harshabose/sagewire/README.md

# sagewire

Avionics wiring and system architecture documentation for **Sage**.

This repository holds the wiring definitions (connections, cable specifications, bill of materials) and the system architecture diagram for Sage's avionics.

## Status

Work in progress.

## Detailed wiring (WireViz)

One YAML file per system in `harness/`. Render one with:

```
wireviz -f hpst -o build harness\power_system.yaml
```

Needs Graphviz on the PATH. In pin lists, quote labels that YAML would read as booleans (`"NO"`, `"ON"`, `"Y"`).
