harshabose/sagewire/docs/CAN Termination for Servos.md

> [!NOTE] Statements
> 1. CubeOrange+ has 2 CAN ports and each one is terminated with a 120$\,\Omega$.
> 2. 4 Servos are DroneCAN protocol; with two on each wing split. Servos do have termination resistors built-in.
> 3. GPS and Airspeed sensor can share one CAN port and daisy-chained together with termination OFF on GPS.

what is to be done:
1. 
2. CAN terminator??
3. 5G modem to antenna
4. RF Antennas
5. A8MINI power
6. FC to Jetson telem
7. ESC capacitors

what cannot be done:
1. battery to PDB
2.
