harshabose/sagewire/docs/component_list.md

| Sr. No | Component Name | Tag  |
| --- | --- | ---- |
| 1 | Pixhawk CubeOrange | FCT  |
| 2 | Airspeed Sensor | SPD  |
| 3 | SF30/D LiDAR | LDR  |
| 4 | Sierra Precision Pro X2 | GPS  |
| 5 | StrobeIT Light | LED  |
| 6 | A2-MINI | A2M  |
| 7 | Doodle Labs Mesh Rider Mini RM-1400-42M3 | AIR  |
| 8 | Battery Front | BAT1 |
| 9 | Battery Back | BAT2 |
| 10 | KDE-UBEC | BEC  |
| 11 | AXLDrone PDB400 | PDB  |
| 12 | ESC | ESC  |
| 13 | Jetson Board (fix board) | JET  |
| 14 | TEVM-AR0234 Mono Camera\* | |
| 15 | Waveshare 5G Dongle | WAV  |
# Connections
