harshabose/sagewire/scrap/Avionics Selection.xlsx

Sheet: Sheet1
Component | Possible Product
Flight Controller | Cube Orange Plus | Weight
 |  | Cost
 | Remarks | Specific Specs
GNSS & RTK Base | Here 4 | 0.06 | Sierra PrecisionPoin Pro (https://www.sierraaerospace.in/) | 0.015 | Teravolt AeroNav-1 (https://www.teravolt.in/product-page/aeronav-1-dual-band-gnss) | 0.025
 |  | 42500 |  |  |  | 15000
 | u-blox F9P | L1 & L5 Bands | RTK | CAN Comm. | Ublox F9/F20 | L1+L2/ L1+L5/ L1+L2+L5 | RTK | CAN Comm. | (NavIC + L1/L5) | UART/I²C Comm.
Battery | mPower 12S 50Ah 400Wh/Kg | 6.336 | mPower 12S 25Ah 350 Wh/Kg | 5.88 | GenX 12S 29Ah 575 Wh/Kg (https://genxbattery.com/shop/genx-pro-solid-state-45-6v-12s-29000mah-3c-premium-lithium-ion-solid-state-rechargeable-battery-575wh-kg) | 5.36
 |  |  |  |  |  | 309265
 | 5C Peak Claimed | Splitting into 2 | 3C Conti. Claimed | 15C Peak Claimed | 2 Units in Parallel | 10C Conti. Claimed | 3C Peak Claimed | 2 Units in Parallel | 2C Conti. Claimed
Servos | HiTec MD950TW-DroneCAN (https://www.hiteccs.com/actuators/product-details/MD950TW-DroneCAN) | 4V - 8.4V | Zeus Z1500H-24V (https://zeus-actuators.com/15mm/Z1500H-24V) | 16V - 30V | Himark SF1607 (http://himarkuaveng.com/product-21898-182293.html) | 4.8V - 8.4V
 |  | 21500
 | 21 Kgcm - 35 Kgcm | 66.4 g | IP54 | CAN Comm. | 6.0 kg-cm - 20 kg-cm | 38 g | MIL-STD-810G | 90° | CAN Comm. | 6.5 kg-cm - 16 kg-cm | 49.5 g | IP64 | 120° | CAN Comm.
Airspeed Sensor | 3DR AUAV-L10D-M25125 (https://store.3dr.com/slim-auav-can-airspeed-sensor/) | 0.02 | Sierra TrueSpeed V2 (https://www.sierraaerospace.in/)
 |  | 14000
 | 4.5 V – 40 V | CAN Comm.
Altitude LiDAR
Current Sensor
3 Axis Camera | SIYI A8 Mini (https://robu.in/product/siyi-a8-mini-ultra-hd-6x-digital-zoom-gimbal-camera/) | 0.1
 |  | 26500
 | 4K Record | UART & SBUS | Ethernet | 1080p 3Axis Gimbal
Power Switch
BECs | Matek 12S Pro (https://robu.in/product/rts-mateksys-12s-pro-bec-9-55v-to-5v-8v-12v-5a/) | 0.005
 |  | 1650
 | Optional 5V, 8V & 12V | Peak 9A | 5 A Continuous
PDB | APD PDB500X (https://powerdrives.net/pdb500x) | 0.05 | Vector Technics Powercore MK2 (https://www.vectortechnics.com/power-electronics-products/powercore-mk2) | 0.16
 |  | 16000
 | 5V & 12V BECs onboard | 1000 A Burst | 500 A (Quad Setup) | Need to use 2 | 300 A (Peak)
Edge Computer | NVIDIA Jetson Orin Nano
GSM Module
LEDs & LED Controller | Teravolt StrobeIT (https://www.teravolt.in/product-page/strobeit) | 0.01
 |  | 1500
 | RGB LED (3W max) | Programmable | 5 V
RF Module | Doodle labs Nano | 0.135 | pMDDL2460 | 0.0483
 |  | 160000 |  | 200000
 | 4 Antennae | 330 Km Range | 4 Antennae | Not Defined
Dropping Mechanism
ESCs | Reflex Drive 12S 80A (https://reflexdrive.in/product/rd-a-series-esc-12s-80a/) | 0.113
 |  | 26000
 | 12S | IP57 | PWM & DSHOT | No Telemetry | 80A
Connectors
Motor Connectors | QS12 Connectors (https://robu.in/product/qs12-connector-black-anti-spark-connector/) | 320A Peak
 |  | 4 Pin Signal Connector
 | Gold Plated Brass | Anti Spark Connector

Sheet: Sheet2
Status | Component | Name | Country of Origin | Units | Weight (g) | Cost | CAD | Procurement Remark
Fixed | Flight Controller | Orange Cube+ Standard Set ADS-B | Taiwan | 1 | 73
 |  | 32-bit ARM Cortex-M4 (STM32F427 Rev 3) running at 168 MHz with 256 KB
Fixed | GNSS & RTK Base | Sierra PrecisionPoin Pro (https://www.sierraaerospace.in/) | India | 1 | 15
 |  | Ublox F9/F20 | L1+L2/ L1+L5/ L1+L2+L5 | RTK
Not Fixed | Battery | mPower 12S 25Ah, 10c, 350 Wh/Kg | India | 2 | 4200
Not Fixed | Servos | Zeus Z1500H-24V (https://zeus-actuators.com/15mm/Z1500H-24V) | Taiwan | 4* | 38
 |  | Continuous torque considered for cuise velocity and max deflection
Fixed | Airspeed Sensor | Sierra TrueSpeed V2 (https://www.sierraaerospace.in/) | India | 2 | ?
Fixed | Altitude LiDAR | LightWare GRF-500 (https://lightwarelidar.com/shop/grf-500/) | USA | 1 | 10.7
Fixed | Current Sensor | Integrated in AXL PDB | India | - | 0
Fixed | 3 Axis Camera | A8 Mini/ A2 Mini | China | 1 | 95/85
 |  | Need to search for alternatives
Not Fixed | Power Switch | High Head 22mm 3-50V |  | 1
 |  | Verify Weight and look for alternatives
Not Fixed | BECs | KDE-UBECUVC | USA |  | 90
Not Fixed | PDB | AXL 400 (https://shop.axldrone.com/products/400a-power-distribution-board/2411087000001838001) | India | 1 | 55
Fixed | Edge Computer | Jetson dev_kit with Orin NX 16 GB | USA | 1 | 175
Fixed | GSM Module | Dual -Telet with Waveshare Module | USA | 1
Fixed | LEDs & LED Controller | StrobeIT-Pro RGB Navigation Strobe | 3km+ Visibility (https://www.teravolt.in/product-page/strobeit-pro-dual-led-drone-strobe) | India | 6 | 8
 |  | Controler need to be verified with wire diagram
Fixed | RF Module | Doodle Labs RM-2450-12M3 mini Mesh Rider® (https://doodlelabs.com/products/radios/mini) | USA | 2 | 34
Not Fixed | Dropping Mechanism |  |  | 1
 |  | Actuator and required electronics to be selected
Fixed | ESCs | APD 120F3 (https://powerdrives.net/120f3) | Australia | 5 | 20
Not Fixed | Forward Motors |  |  | 1
Fixed | VTOL Motors | Vector Technics 8020 Pro (https://www.vectortechnics.com/motors-products/8020-pro-120-kv) | India | 4 | 580
Fixed | Forward Propeller | APC 18 × 10E (https://www.apcprop.com/product/18x10e/?v=13b5bfe96f3e) |  | 1 | 72.8
Not Fixed | VTOL Propeller |  |  | 4
 | Connectors
 | Motor Connectors
