harshabose/sagewire/scrap/initial_selection.xlsx

GSM Module |  | Flight Controller |  | Battery |  | Servos | Airspeed Sensor |  | Altitude LiDAR |  | 3 Axis Camera | BEC |  | PDB |  | RF System | ESC
Min Requirements |  | Min Requirements |  | Min Requirements |  |  | Min Requirements |  | Min Requirements |  | Min Requirements | Min Requirements |  | Min Requirements
1. Low number of Antennas 2. Low Cost 3. Non-Chinese 4. -30C to 70C operational temperature 5. Support Airtel (5G-NSA, 4G LTE) and Jio (5G-SA, 4G LTE) Airtel 4G LTE -B1, B5, B40, B3, B8; 5G NSA - n8, n3, n1, n78, n258 Jio 4G LTE -B40, B3, B5 ; Jio 5G NSA - n28, n78, n258 |  |  |  | 1. 12S, 50Ah, high energy density 2. 400A draw |  | # todo |  |  | 1. DroneCAN/UART comm 2. 200m range (500m prefred) 3. Opererable in high lux 4. IP rated? 5. Non-chinese |  | 1. 3 axis stabilised gimbal 2. Compatible with MAVLINK/Drone 3. Cost similar to SIYI A8-MINI ($250) 4. Weight similar to SIYI A8-MINI (95g) 5. upto 10x (digital; low-priority) 6. Non-chinese | 1. 5V 3A Cont. 5A Burst 2. 5V 5A Cont. 10A Burst 3. 2X 12V 10A Cont. 15A Burst 4. Non-chinese |  | 1. 400A continuous current, 12S 2. Each ESC leg should have atleast 100A 3. Support for atleast 4 ESC legs in setup 4. BEC - 5V (x2) 3A/5A, 12V(x2) 10A/10A cont. (optional) 5. Current, Voltage measurement 6. Non-chinese |  |  | 1. 80A Cont. 100A Burst 12S 3. under 150g 3. non-chinese
Selection #1 |  | Selection #1 |  | Selection #1 |  |  | Selection #1 |  | Selection #1 (Sensor Team) |  | Selection #1 | Selection #1 |  | Selection #1 |  | Selection #1 | Selection #1
Name | Sierra EM8695 RedCap | Name | Cube Orange Plus | Name | mPower 12S |  | Name | 3DR AUAV-L10D-M25125 | Name | LightWare SF30/D LiDAR |  | Name | Hub-E High-Performance H4 Cube | Name | AxlDrone PDB400A | RC7 | Name | Reflex Drive A-Series ESC 80A
Antennas | 2 | Weight | 73g | Config | 1 |  | Pressure Range | +/- 10 inH20 | Range/Accuracy | 0.2m - 200m / +/- 5cm (<500reads/s) |  | Weight | 102g | Weight | 55g | doodle lab | Weight | 90g (without cable)
Country of Origin | USA | Country of Origin | Australian (manuf. Taiwan) | Energy Density | 400 Wh/kg |  | Weight | 2.8g | Weight | 35g |  | Input Voltage | 4-14S | Cont. Current | 400A |  | IP Rating | IP57
Cost | $168 | Cost | 64000 INR | Capacity | 50Ah |  | Country of Origin | USA | Voltage | 4.5V to 5.5V |  | 5V Outputs | 5.3V X2 (10A Cont.; 15A Burst) | Peak Current | 500A |  | Interface | PWM, DShot300
Buy Links | Techship (https://techship.com/product/sierra-wireless-em8695-5g-redcap-m2/?variant=002) | Processor | Main: STM32H757ZI ARM Cortex M7 (400 MHz) Fallover: STM32F103 ARM Cortex M3 (24MHz) | Weight | 6.336 kg |  | Interface | DroneCan | Interface | Serial (FC) |  | 12V Outputs | 12V X2 (10A Cont.; 15A Burst) | ESC legs | 8 |  | Telemetry | YES
Op. Temp. Range | -30C to +70C | Sensors | Accelerometer (x3); Gyroscope (x3); Compass (x1); Barometer (x2) | Cost |  |  | Op. Temp. Range | -40 °C to 85 °C | Op. Temp | -20 to 60°C |  | Selection #2 (search for alternatives) |  | ESC cont. Current | - |  | Current | 80A (Cont.) & 100A (Burst)
Interface | M2 | Op. Temp. Range | -10C to 55C | Cont. C Rating | 3C |  | Selection #2 |  | Test Plan |  |  | Test Plan |  | ESC max. Current | 200A |  | Test Plan
Uplink/Downlink (Mbps) | 100/220 | Test Plan |  | Max. C Rating | 5C |  | Name | AUAV DroneCAN Airspeed & Baro Sensor CN | Delegated to Sensor Suite Team |  |  | Load Regulation Test (requires DC power supply and DC load) | Test: Validate DC voltage stability across the 14S input range (36V to 51V) and from 0A to 10A continuous draw per rail. Procedure: 1. Wire the input to a DC supply adjustable from 36V to 51V. 2. Connect electronic loads to each 5V and 12V output channel. 3. Stepping througgh delta 1V on DC supply, step current load from 0A to 10A in 1A increments per rail and record terminal voltage with a calibrated digital multimeter. 4. Monitor internal buck ICs, inductors, and PCB copper traces using thermal camera. after reaching thermal equilibrium (delta T < 1C/min) Output voltages should remain within ±6% of nominal under all line/load combinations (4.80V–5.5V for 5.3V rails; 11.3V–12.7V for 12V rails). Surface temperature of power components remains < 110C, no thermal shutdown triggers | BECs 5V 3A/5A | YES/NO |  | Continuous & Burst Load Thermal Test | Test: Verify continuous 80A current-handling capability and 100A burst threshold (15-second duration) without MOSFET thermal runaway or component degradation. Procedure: 1. Supply maximum rated battery voltage (up to 12S / 50.4V) and apply a constant 80A current load for 10 minutes. (run BH NIPPLE at max throttle sea level ~80A) 2. Apply 100A (how to control current consp.? could reduce voltage?) burst current steps for 15 seconds at 2-minute intervals during the continuous run. 3. Track surface temperatures and solder pads, wires using thermal camera. Maximum surface temperature remains below 100C(?)
5G bands | n1, n2, n3, n5, n7, n8, n12, n13, n14, n18, n20, n25, n26, n28, n30, n38, n40, n41, n48, n66, n70, n71, n77, n78, n79 | NONE (NOT sure if FC team's code/hardware or Ardupilot) |  | Selection #2 |  |  | Pressure Range | +/- 10 inH20 |  |  |  |  |  | BECs 12V 10A/10A | NO/NO
4g bands | B1, B2, B3, B4, B5, B7, B8, B12, B13, B14, B17, B18, B19, B20, B25, B26, B28, B30, B34, B38, B39, B40, B41, B42, B43, B48, B66, B71, B106 |  |  | Name | mPower 12S |  | Weight | 10g |  |  |  |  |  | Current Voltage sensors | YES
Selection #2 |  |  |  | Config | 1+1 (parallel) |  | Country of Origin | German |  |  |  |  |  | Require Anti-spark? | NO
Name | Telit Cinterion FN920C04-WW 5G RedCap M.2 |  |  | Energy Density | 350 Wh/kg |  | Interface | Redundant DroneCAN x2 |  |  |  |  |  | Test Plan
Antennas | 2 |  |  | Capacity | 25Ah + 25 Ah |  | Op. Temp. Range | -40 °C to 85 °C |  |  |  |  |  | Current/Voltage Sensor Accuracy & Calib | Test: Validate current measurement precision and calibrate scale/offset parameters across the full operating range (0A to Imax). Procedure: 1. Wire the current sensor in series with a precision programmable DC electronic load (buy this) and a bench multimeter. 2. Measure zero-current offset at boot (I = 0A) to verify baseline reading (BATT_AMP_OFFSET) (follow ardupilot guide on their website) 3. Perform a 10-step ascending and descending current sweep from 0A to maximum rated current 4. Log telemetry output I_ouput versus reference output I_load to calculate BATT_AMP_OFFSET, hysteresis, and linearity (R^2 > 0.999). Target full-scale accuracy is 1.5%. 5. Similarily with voltage with varying DC supply (range = 36V to 52V for 12S) BATT_VOLT_MULT (follow ardupilot guide on their website)
Country of Origin | Italy |  |  | Weight | 5.88 kg |  | Selection #3
Cost | $160 |  |  | Cost |  |  | Name | Beyond Robotrix Air Data Module Mini
Buy Links | Techship (https://techship.com/product/telit-cinterion-fn920c04-ww-5g-redcap-m2/?variant=006) |  |  | Cont. C Rating | 10C |  | Pressure Range | +/- 10 inH20
Op. Temp. Range | -40C to +85C |  |  | Max. C Rating | 15C |  | Weight | 3.9g
Interface | M2 |  |  | Test Plan |  |  | Country of Origin | UK
Uplink/Downlink (Mbps) | 123/223 |  |  |  |  |  | Interface | CAN
5G bands | n1, n2, n3, n5, n7, n8, n12, n13, n14, n18, n20, n25, n26, n28, n30, n38, n40, n41, n48, n53, n66, n70, n71, n77, n78, n79 |  |  | Parallel Current Sharing |  |  | Op. Temp. Range | -40 °C to +85 °C
4g bands | B1, B2, B3, B4, B5, B7, B8, B12, B13, B14, B17, B18, B19, B20, B25, B26, B28, B30, B34, B38, B39, B40, B41, B42, B43, B48, B66, B71 |  |  | Inrush Cross-Charging when Voltage Mismatch Test |  |  | Test Plan |  |  |  |  |  |  |  |  |  | IP Protection Test (Required?)
Selection #3 |  |  |  | 400A Continuous Full-Discharge Thermal Test (8C Rate) |  |  | Accuracy Test Plan | Test: The sensor should be able to measure accurately, specifically - stall speed, cruise speed, AoA, side-slip, and high-speed (dive speed) Procedure (from Arduploit website): 1. Fly at constant altitude (100-200m) in circles with ARPSPD_USE=0 (but collect data), varying speeds 2. Calculate average TAS and compare with GPS speed vectors - error should be <3% 3. Repeat this with varying speed (and AoA) |  |  |  | Burst Load Capacity Test (requires DC power suppl, DC load and oscilloscope) | Test: Evaluate voltage recovery and transient sag during maximum 15A burst events on individual and combined channels. Procedure: 1. Set input supply to nominal 12S voltage (50.4V). 2. Program the DC load to step from 2A (low) continuous baseline to 15A peak with a 1-second pulse duration (slew rate ≥ 2.5A/µs). 3. Measure transient voltage dip, overshoot, and settling time using an oscilloscope (check if we have this in lab) connected directly across the BEC output pads. Repeat test with pulsed load applied simultaneously across all 4 output channels (dual 5V + dual 12V). Peak-to-peak transient deviation remains < 6% of nominal voltage, recovery time < 200µs (?), and no triggering of over-current protection.
Name | CQM220 5G RedCap IoT Module |  |  | Single-Pack Failure Test | Test: Confirm battery safety if one pack unexpectedly fails during full-power (max motor current; 300A) operation. Procedure: 1. Operate system at 300A total load (150A per pack) connected to PDB. Trigger an intentional disconnect/fuse-switch off on Pack 1. 2. Measure instantaneous voltage spike, current ramp on Pack 2 (from 150A to 300A) on telemetry. Remaining pack absorbs the current without triggering over-current shutdown (since 300A is within its single-pack 10C / 250A continuous and 15C burst rating)
Antennas | 2
Country of Origin | USA (RnD India)
Cost | Enquiry |  |  |  |  |  |  |  |  |  |  |  |  | High-Load Thermal; BEC Voltage regulation @ High-Load; EMF Leak | Test: Validate thermal equilibrium under continuous 400A total load 100A per leg across 4 legs) at 12S nominal voltage (48V - 50.4V. Procedure: 1. Mount the PDB inside on a test rig. Wire 4 ESC output legs to DC electronic loads 100A per channel) and connect input terminals to a 12S DC power supply. 2. Apply continuous 400A load for 15 minutes or until thermal steady-state is established (Delta T < 1C/min). 3. Record surface temperature at the current shunts, main power solder pads, and heavy copper traces every 30 seconds using thermal imaging. Temp should be stable and < 100C(?) 4. Measure total system voltage drop (V_in - V_leg) - should be less than 1-2% (?); and 5V BEC voltage regulation - should be less than 6% (5.3V) ripple. 5. While max current draw, measure the raw EMF samples - power, frequency, bandwidth. Verify if any rogue EMF falls in GNSS/5G/2.4GHz/5.8GHz range.
Op. Temp. Range | -30C to 85C |  |  |  |  |  | Calibration Test Plan | Test: The sensor's error with position, altitude, operations etc should be considered. Ardupilot provides default features to correct this Procedure (from Arduploit website): 1. Set ARSPD_USE = 0 to not use the airspeed sensor during test 2. Set the current ambient temp. in BARO_GND_TEMP (Ardupilot uses internal temp automatically) 3. ARSPD_RATIO = 2.0 (Default) ARSPD_AUTOCAL = 1. And FLWA for 5 minutes in Loiter and Fly in circles at low speed in calm wind (<3m/s) 4. The ARSPED_RATIO value will automatically change (1.5 to 3.0). Change ARSPD_AUTOCAL=0 to conclude the test. If the ratio is outside the limit, there is a leak. NOTE: Do the same at high altitude (every 2000m will give 10% error). Ardupilot auto corrects this. |  |  |  | Short-Circuit & Protection Recovery Test | Test: Confirm output short-circuit protection and auto-recovery prevent board damage during shorts. Procedure: 1. Apply a direct very small resistance short circuit < 10mOhms sequentially to each 5V and 12V output terminal under nominal 12S input voltage. 2. Hold short circuit for 30 seconds and record fault behavior (hiccup mode vs. latch-off). 3. Remove short circuit and measure time-to-recovery for voltage output (multimeter) Zero physical damage to PCB or ICs, shorted current limited safely, and full auto-recovery within few second after fault removal.
Interface | M2 available |  |  |  |  |  | Presure Leak Test | Test: The hardware (pipes, tubes, connectors, etc) should be leak proof Procedure: 1. Attach a precision pressure calibrator (or syringe with a digital manometer) to the pitot port while leaving the static port exposed to ambient air. 2. Apply positive pressure equivalent to maximum operational dynamic pressure (VD). 3. Verify pressure decay is less than $0.5hPa/min (<2% total pressure loss). 4. Repeat the procedure on the static port using negative suction pressure.
Uplink/Downlink (Mbps) | 120/220
5G bands | WW - n1, n2, n3, n5, n7, n8, n12, n13, n14, n18, n20, n25, n26, n28, n38, n40, n41, n48, n66, n71, n77, n78 IN - n1, n3, n5, n8, n38, n40, n41, n48, n77, n78 EAJ - n1, n3, n5, n7, n8, n18, n20, n26, n28, n38, n40, n41, n48, n77, n78
4g bands | WW - B1, B2, B3, B4, B5, B7, B8, B12, B13, B14, B17, B18, B19, B20, B25, B26, B28, B34, B38, B39, B40, B41, B42, B43, B48, B66, B71 IN - B1, B3, B5, B8, B38, B40, B41, B42, B43, B48 EAJ - B1, B3, B5, B7, B8, B18, B19, B20, B26, B28, B34, B38, B39, B40, B41, B42, B43, B48
Comment | RedCap are ideal for drone - lower cost, lower power, lower antennas but, only work 5G-SA (no NSA) and 4G networks. Airtel is 5G-NSA (soon transitioning to SA). Jio is 5G-SA. This means when using airtel, modules will fallback to 4G LTE+. This is fine as in most deployment places we are already using 4G.
Test Plan
Delegated to comms. team
