harshabose/sagewire/scrap/SAGE_Master.step

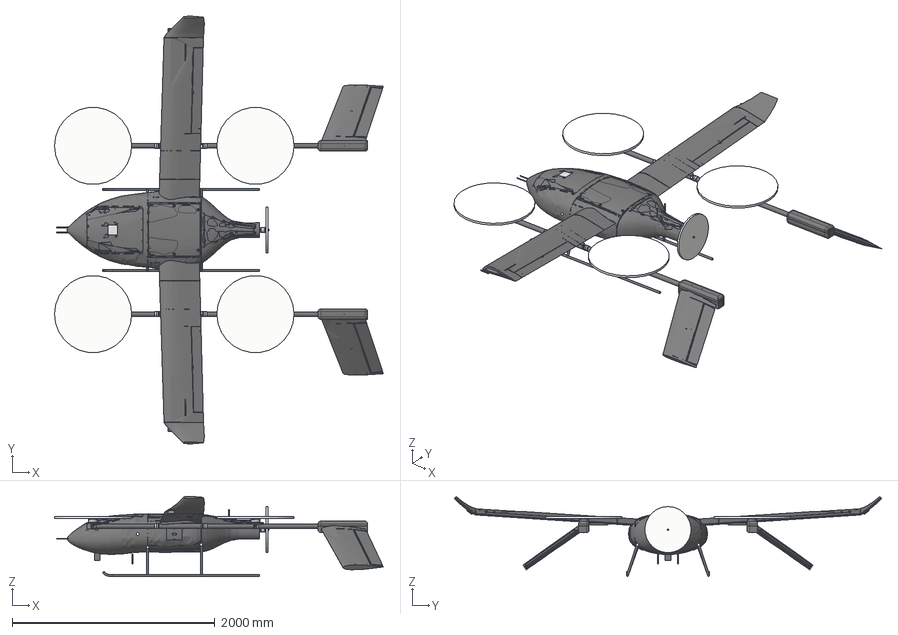
[picture p1: CAD file, 2026-11-13]
scrap/SAGE_Master.step
3246.6 x 4221.3 x 790.4 mm
RF_Window_GNSS_GFRP
HW_M3x10_CSK_Captive_Screw x 24
HW_Nutplate_M3_2Lug_Floating x 24
GNSS_Holder_PA12
HW_Kit_SparFitting_Inner_Main x 2
HW_Kit_SparFitting_Inner_Aux x 2
HW_Kit_SparFitting_Outer_Main x 2
HW_Kit_SparFitting_Outer_Aux x 2
COTS_Servo_Z1500H x 6
COTS_Servo_Arm_Single_13 x 4
HW_Pushrod_M2_L52 x 4
15.1_Payload_Top_Hatch
15.2_Bay_Door_L
15.3_Bay_Door_R
CON_XT90_Female x 4
CON_M8_4pin_Female x 4
CON_DSUB25_Female x 2
CON_M8_3pin_Female x 4
CON_Phase3_Bullet4mm_Female x 4
AV_ESC_APD_120F3 x 5
CON_DSUB25_Male x 2
CON_XT90_Male x 4
CON_M8_4pin_Male x 4
HW_Hinge_Pin_20mm x 16
CON_M8_3pin_Male x 4
CON_Phase3_Bullet4mm_Male x 4
42.1_Tail_Boom_Joint_R
41.1_Tail_Boom_Joint_L
COTS_Motor_VT8020PRO_120KV x 4
FAB_VTOL_Motor_Mount_v5 x 4
AV_Prop_APC_18x10E
COTS_Motor_VT4130FW_300KV
HW_Washer_M8_DIN125
HW_Nut_M8_Nyloc_DIN985
BATT_Bay_Receptacle_R
01_Pack_12S1P_LiPo
02_Case_PA12_Latches_Slides
03_Blade_Plug
BATT_Bay_Receptacle_L
01_Pack_12S1P_LiPo_1
02_Case_PA12_Latches_Slides_1
03_Blade_Plug_1
AV_FC_CubeOrangePlus_ADSB
AV_Radio_DoodleLabs_RM2450_Mini x 2
AV_GSM_DualTelet_Waveshare
AV_GNSS_Sierra_PrecisionPoint_Pro
AV_LiDAR_LightWare_GRF500
AV_Airspeed_Sierra_TrueSpeedV2 x 2
AV_Power_Switch_22mm
AV_Jetson_OrinNX_DevKit
AV_PDB_AXL400
AV_BEC_KDE_UBECUVC
AV_Camera_SIYI_A8mini
AV_LED_StrobeIT_Pro x 2
AV_Antenna_Whip x 4
AV_LED_StrobeIT x 4
70_Landing_Gear
