harshabose/sagewire/harness/actuators_system.yaml

# Actuators system harness (work in progress)
# Scope: wing split -> ESC power input -> motor phase leads for the four VTOL motors (numbered as in
# the ArduPilot Quad X default: 1 front right, 2 rear left, 3 front left, 4 rear right)
# (XT90 male on the wing side, APD 120F3 ESC, Vector Technics 8020 PRO 120KV motor), plus the
# forward-thrust ESC and motor.
# The fuselage side (PDB ESC pads -> XT90 female) lives in power_system.yaml. The ESC signal (T, S)
# wiring is in the wing split section. The two input capacitors that come in each ESC box (not
# installed) are soldered with their own legs straight onto the ESC capacitor pads (CAP_xxx_A and
# CAP_xxx_B, cables W_ACT_32 to W_ACT_41); their spec is not in the APD docs.
# The forward-thrust ESC (same APD 120F3) is wired to the PDB in power_system.yaml (ESC_FWD_IN);
# its signal, capacitor and motor phase pads are here (ESC_FWD_SIG, ESC_FWD_CAP, ESC_FWD_PH), and
# the motor is a Vector Technics VT4130 300KV with an 18 inch propeller.
# The wing split signal connectors (DB-25, one pair per wing), the wing servos, the wing LEDs and the
# CAN splitter ports are at the end of the connectors section. They are wired with NO SHARING: every
# servo, LED and ESC signal link has its own power, ground and signal pins through the DB-25, and
# every servo has its own CAN pair plus a GND wire to its own port on the passive CAN splitter
# (ports 2 to 5; port 1, the Cube link, is in flight_control_system.yaml). The servo end of each wing
# cable is an M5 male plug that mates with the servo's own M5 lead. The DB-25 pin order
# below is provisional (not fixed yet). The fuselage side sources (12 V, 5 V, Cube outputs) are not
# modelled yet, so those fuselage pins only show the mate to the wing side, apart from the CAN
# and GND wires to the splitter.
#
# Cable lengths are 0 for now (placeholder). Real lengths come after the layout analysis.
# Gauges and colors are recommendations, see the comment above each cable.

metadata:
  title: Actuators system
  description: VTOL motor power, wing split (DB-25, no sharing), servos, LEDs, ESC signals, CAN splitter ports

connectors:

  # Wing split, wing side: one XT90 male per VTOL motor ESC. It mates with the XT90 female
  # in power_system.yaml (XT90_VTOL{n}_F). Synthetic pin IDs; the housing is keyed, so polarity
  # cannot be reversed.
  # Variant fixed for now: plain XT90 (no anti-spark). TODO: revisit the variant (XT90-S anti-spark
  # or XT90H) and set the part number. It must match the female side. XT90 is rated for 90 A continuous: check against the real ESC peak current.
  XT90_VTOL1_M:
    type: XT90 male
    subtype: male
    manufacturer: Amass
    notes: "VTOL motor 1 (front right) power, wing split (wing side)"
    pinlabels: [POS, NEG]

  XT90_VTOL2_M:
    type: XT90 male
    subtype: male
    manufacturer: Amass
    notes: "VTOL motor 2 (rear left) power, wing split (wing side)"
    pinlabels: [POS, NEG]

  XT90_VTOL3_M:
    type: XT90 male
    subtype: male
    manufacturer: Amass
    notes: "VTOL motor 3 (front left) power, wing split (wing side)"
    pinlabels: [POS, NEG]

  XT90_VTOL4_M:
    type: XT90 male
    subtype: male
    manufacturer: Amass
    notes: "VTOL motor 4 (rear right) power, wing split (wing side)"
    pinlabels: [POS, NEG]

  # ESC: APD 120F3 (120 A rating), one per VTOL motor. All its connections are solder pads, so
  # there is nothing to buy on the ESC side; the harness wires are soldered straight to the pads.
  # The board has three groups of pads, modelled as three connectors per ESC. Pin IDs are
  # synthetic (pads have no numbers), in label order.
  # TODO: the pad picture was of the F3[X] board; confirm the 120F3 pad layout is the same.
  # Capacitors: each 120F3 box has 2 input capacitors (not installed), modelled further down as
  # CAP_xxx_A and CAP_xxx_B. APD says that if the ESC is more than 12 cm from the power source an
  # additional capacitor is needed on top of the included ones (2 or 3 extra for high current;
  # Panasonic FM/FS or Rubycon ZLJ). The wing ESCs will be over 12 cm (wing split).
  # TODO: the value and voltage of the included capacitors are not in the APD docs. Read the
  # markings on them, then decide the extra capacitors for the long input leads.
  #
  # Battery input pads (+ and -, the two large pads).
  ESC_VTOL1_IN:
    type: Solder pads
    notes: "VTOL motor 1 (front right) ESC battery input, + and -"
    pinlabels: [IN_POS, IN_NEG]
    ignore_in_bom: true

  ESC_VTOL2_IN:
    type: Solder pads
    notes: "VTOL motor 2 (rear left) ESC battery input, + and -"
    pinlabels: [IN_POS, IN_NEG]
    ignore_in_bom: true

  ESC_VTOL3_IN:
    type: Solder pads
    notes: "VTOL motor 3 (front left) ESC battery input, + and -"
    pinlabels: [IN_POS, IN_NEG]
    ignore_in_bom: true

  ESC_VTOL4_IN:
    type: Solder pads
    notes: "VTOL motor 4 (rear right) ESC battery input, + and -"
    pinlabels: [IN_POS, IN_NEG]
    ignore_in_bom: true

  # Motor phase pads on the ESC (three pads). Sensorless motor, so the three phases can go to any
  # pad: swapping any two phase wires reverses the spin direction (APD also has a motor reverse
  # solder tab). Pad labels are synthetic.
  # TODO: check the real pad labels on the 120F3 board and set the spin direction per motor.
  ESC_VTOL1_PH:
    type: Solder pads
    notes: "VTOL motor 1 (front right) ESC motor phase pads"
    pinlabels: [PH_A, PH_B, PH_C]
    ignore_in_bom: true

  ESC_VTOL2_PH:
    type: Solder pads
    notes: "VTOL motor 2 (rear left) ESC motor phase pads"
    pinlabels: [PH_A, PH_B, PH_C]
    ignore_in_bom: true

  ESC_VTOL3_PH:
    type: Solder pads
    notes: "VTOL motor 3 (front left) ESC motor phase pads"
    pinlabels: [PH_A, PH_B, PH_C]
    ignore_in_bom: true

  ESC_VTOL4_PH:
    type: Solder pads
    notes: "VTOL motor 4 (rear right) ESC motor phase pads"
    pinlabels: [PH_A, PH_B, PH_C]
    ignore_in_bom: true

  # Vector Technics 8020 PRO 120KV motor, one per VTOL arm. The three phase leads exit the motor
  # body and are modelled as cable W_ACT_05 to W_ACT_08, so nothing goes in the BOM for them.
  # TODO: lead length, gauge and any connector on the leads are not in the seller listing; check
  # the Vector Technics datasheet or the motor itself.
  MOT_VTOL1:
    type: Motor (three-phase leads exit the body)
    manufacturer: Vector Technics
    notes: "VTOL motor 1 (front right, CCW): 8020 PRO 120KV, 12S, 50 A (180 s) maximum continuous per the seller listing"
    pinlabels: [PH_A, PH_B, PH_C]
    ignore_in_bom: true

  MOT_VTOL2:
    type: Motor (three-phase leads exit the body)
    manufacturer: Vector Technics
    notes: "VTOL motor 2 (rear left, CCW): 8020 PRO 120KV, 12S, 50 A (180 s) maximum continuous per the seller listing"
    pinlabels: [PH_A, PH_B, PH_C]
    ignore_in_bom: true

  MOT_VTOL3:
    type: Motor (three-phase leads exit the body)
    manufacturer: Vector Technics
    notes: "VTOL motor 3 (front left, CW): 8020 PRO 120KV, 12S, 50 A (180 s) maximum continuous per the seller listing"
    pinlabels: [PH_A, PH_B, PH_C]
    ignore_in_bom: true

  MOT_VTOL4:
    type: Motor (three-phase leads exit the body)
    manufacturer: Vector Technics
    notes: "VTOL motor 4 (rear right, CW): 8020 PRO 120KV, 12S, 50 A (180 s) maximum continuous per the seller listing"
    pinlabels: [PH_A, PH_B, PH_C]
    ignore_in_bom: true

  # Signal pads (three small pads, top to bottom: T, S, -).
  # T = ESC telemetry output, S = signal input (PWM), - = signal ground.
  ESC_VTOL1_SIG:
    type: Solder pads
    notes: "VTOL motor 1 (front right) ESC signal pads: T telemetry out, S signal in, GND signal ground"
    pinlabels: [T, S, SIG_GND]
    ignore_in_bom: true

  ESC_VTOL2_SIG:
    type: Solder pads
    notes: "VTOL motor 2 (rear left) ESC signal pads: T telemetry out, S signal in, GND signal ground"
    pinlabels: [T, S, SIG_GND]
    ignore_in_bom: true

  ESC_VTOL3_SIG:
    type: Solder pads
    notes: "VTOL motor 3 (front left) ESC signal pads: T telemetry out, S signal in, GND signal ground"
    pinlabels: [T, S, SIG_GND]
    ignore_in_bom: true

  ESC_VTOL4_SIG:
    type: Solder pads
    notes: "VTOL motor 4 (rear right) ESC signal pads: T telemetry out, S signal in, GND signal ground"
    pinlabels: [T, S, SIG_GND]
    ignore_in_bom: true

  # Capacitor pads (+ and -, marked "Capacitor Mounting Position" on the board, at the top edge).
  # The two capacitors from the ESC box are soldered straight onto these pads with their own legs
  # (CAP_VTOL1_A and CAP_VTOL1_B, both on the same pad pair, in parallel). Extra capacitors for
  # the long input leads are not added yet.
  ESC_VTOL1_CAP:
    type: Solder pads
    notes: "VTOL motor 1 (front right) ESC capacitor pads, + and -. Observe polarity."
    pinlabels: [CAP_POS, CAP_NEG]
    ignore_in_bom: true

  ESC_VTOL2_CAP:
    type: Solder pads
    notes: "VTOL motor 2 (rear left) ESC capacitor pads, + and -. Observe polarity."
    pinlabels: [CAP_POS, CAP_NEG]
    ignore_in_bom: true

  ESC_VTOL3_CAP:
    type: Solder pads
    notes: "VTOL motor 3 (front left) ESC capacitor pads, + and -. Observe polarity."
    pinlabels: [CAP_POS, CAP_NEG]
    ignore_in_bom: true

  ESC_VTOL4_CAP:
    type: Solder pads
    notes: "VTOL motor 4 (rear right) ESC capacitor pads, + and -. Observe polarity."
    pinlabels: [CAP_POS, CAP_NEG]
    ignore_in_bom: true

  # --- Forward-thrust ESC (APD 120F3, same as the VTOL ESCs) ---------------------------
  # Battery input pads are in power_system.yaml (ESC_FWD_IN). Same pad layout as above.
  # Signal pads (top to bottom: T, S, -). T = telemetry out, S = signal in (PWM), - = signal ground.
  ESC_FWD_SIG:
    type: Solder pads
    notes: "Forward ESC signal pads: T telemetry out, S signal in, GND signal ground"
    pinlabels: [T, S, SIG_GND]
    ignore_in_bom: true

  # Capacitor pads (+ and -). The two capacitors from the ESC box are soldered straight onto them
  # with their own legs (CAP_FWD_A and CAP_FWD_B); same capacitor notes as the VTOL ESCs apply.
  ESC_FWD_CAP:
    type: Solder pads
    notes: "Forward ESC capacitor pads, + and -. Observe polarity."
    pinlabels: [CAP_POS, CAP_NEG]
    ignore_in_bom: true

  # Motor phase pads on the forward ESC. Same notes as the VTOL ESCs: any pad order works, and
  # swapping two phase wires reverses the spin direction. Pad labels are synthetic.
  ESC_FWD_PH:
    type: Solder pads
    notes: "Forward ESC motor phase pads"
    pinlabels: [PH_A, PH_B, PH_C]
    ignore_in_bom: true

  # Forward-thrust motor: Vector Technics VT4130 300KV, 18 inch propeller. The three phase leads
  # exit the motor body and are modelled as cable W_ACT_09.
  # TODO: lead length, gauge and any connector are not known; check the Vector Technics datasheet or
  # the motor. The test data is for a smaller propeller; the 18 inch propeller draws more current
  # (agreed with the vendor), expected to be similar to the VTOL motors.
  MOT_FWD:
    type: Motor (three-phase leads exit the body)
    manufacturer: Vector Technics
    notes: "Forward motor: VT4130 300KV, 18 inch propeller"
    pinlabels: [PH_A, PH_B, PH_C]
    ignore_in_bom: true

  # ---- ESC input capacitors from the box (2 per ESC) -----------------------------------
  # Each APD 120F3 ships with 2 input capacitors, not installed. They belong to the ESC, so nothing
  # goes in the BOM. The spec (value, voltage) is not in the APD docs; read it off the capacitor.
  # Polarity: the positive leg is the longer one, the negative side has the grey stripe on the body.
  # Legs as short as possible (APD).
  CAP_VTOL1_A:
    type: Electrolytic capacitor (spec not known)
    notes: "VTOL motor 1 (front right) ESC input capacitor 1 of 2, from the ESC box"
    pinlabels: [CAP_POS, CAP_NEG]
    ignore_in_bom: true

  CAP_VTOL1_B:
    type: Electrolytic capacitor (spec not known)
    notes: "VTOL motor 1 (front right) ESC input capacitor 2 of 2, from the ESC box"
    pinlabels: [CAP_POS, CAP_NEG]
    ignore_in_bom: true

  CAP_VTOL2_A:
    type: Electrolytic capacitor (spec not known)
    notes: "VTOL motor 2 (rear left) ESC input capacitor 1 of 2, from the ESC box"
    pinlabels: [CAP_POS, CAP_NEG]
    ignore_in_bom: true

  CAP_VTOL2_B:
    type: Electrolytic capacitor (spec not known)
    notes: "VTOL motor 2 (rear left) ESC input capacitor 2 of 2, from the ESC box"
    pinlabels: [CAP_POS, CAP_NEG]
    ignore_in_bom: true

  CAP_VTOL3_A:
    type: Electrolytic capacitor (spec not known)
    notes: "VTOL motor 3 (front left) ESC input capacitor 1 of 2, from the ESC box"
    pinlabels: [CAP_POS, CAP_NEG]
    ignore_in_bom: true

  CAP_VTOL3_B:
    type: Electrolytic capacitor (spec not known)
    notes: "VTOL motor 3 (front left) ESC input capacitor 2 of 2, from the ESC box"
    pinlabels: [CAP_POS, CAP_NEG]
    ignore_in_bom: true

  CAP_VTOL4_A:
    type: Electrolytic capacitor (spec not known)
    notes: "VTOL motor 4 (rear right) ESC input capacitor 1 of 2, from the ESC box"
    pinlabels: [CAP_POS, CAP_NEG]
    ignore_in_bom: true

  CAP_VTOL4_B:
    type: Electrolytic capacitor (spec not known)
    notes: "VTOL motor 4 (rear right) ESC input capacitor 2 of 2, from the ESC box"
    pinlabels: [CAP_POS, CAP_NEG]
    ignore_in_bom: true

  CAP_FWD_A:
    type: Electrolytic capacitor (spec not known)
    notes: "Forward ESC input capacitor 1 of 2, from the ESC box"
    pinlabels: [CAP_POS, CAP_NEG]
    ignore_in_bom: true

  CAP_FWD_B:
    type: Electrolytic capacitor (spec not known)
    notes: "Forward ESC input capacitor 2 of 2, from the ESC box"
    pinlabels: [CAP_POS, CAP_NEG]
    ignore_in_bom: true

  # ==== Wing split (DB-25) and wing consumers ============================================
  # Each wing carries 2 servos (DroneCAN), 3 LEDs (PWM) and 2 ESC signal links (T, S, GND).
  # Wired with NO SHARING (user decision for now): per servo 12 V and GND, per LED 5 V, signal and
  # GND, per ESC T, S and its own signal GND, and a separate CAN pair per servo. That is 23 pins per
  # wing; pins 24 and 25 are spare. The pin current rating is above what the loads need, including
  # the servos (user check).
  #
  # TODO: the DB-25 pin map below is PROVISIONAL on purpose. Freeze it in a later pass.
  # Provisional DB-25 pin map (identical on both wings, so the harnesses mirror):
  #   1-4   servo 1: V+, GND, CAN_H, CAN_L        5-8   servo 2: V+, GND, CAN_H, CAN_L
  #   9-11  ESC 1 (forward boom): T, S, GND       12-14 ESC 2 (aft boom): T, S, GND
  #   15-17 LED 1: 5 V, signal, GND               18-20 LED 2: 5 V, signal, GND
  #   21-23 wingtip LED: 5 V, signal, GND         24-25 spare
  # The CAN pair of each servo sits on adjacent pins (twist the pair in the cable).
  # Motor numbers follow the ArduPilot QuadPlane Quad X default: 1 front right, 2 rear left,
  # 3 front left, 4 rear right. So the left wing carries VTOL motor 3 (ESC 1, forward boom) and
  # VTOL motor 2 (ESC 2, aft boom); the right wing carries VTOL motor 1 (ESC 1) and 4 (ESC 2).
  # Servos and LEDs: servo 1 and 2, LEDs L1, L2 (StrobeIT-Pro) and LT (wingtip) per wing.
  #
  # DB-25 pair per wing: socket (female) on the fuselage side, plug (male) on the wing side, so the
  # live pins are not exposed on the fuselage side. This gender choice is an assumption.
  # TODO: shell material and part numbers, contact type (crimp or solder), the contact wire range (it
  # must take both the 22 AWG power wires and the 26 AWG signal wires) and the mating hood.
  # TODO: the pin order is not fixed, so all pin references below use the pin labels. Change the
  # label list in the four connectors together.
  SPLIT_L_FUS:
    type: D-sub DB-25 socket
    subtype: female
    pincount: 25
    pinlabels: [SRV1_VPOS, SRV1_GND, SRV1_CANH, SRV1_CANL, SRV2_VPOS, SRV2_GND, SRV2_CANH, SRV2_CANL, ESC1_T, ESC1_S, ESC1_SGND, ESC2_T, ESC2_S, ESC2_SGND, LED1_5V, LED1_SIG, LED1_GND, LED2_5V, LED2_SIG, LED2_GND, LEDT_5V, LEDT_SIG, LEDT_GND, SPARE24, SPARE25]
    hide_disconnected_pins: true
    notes: "Left wing split, fuselage side. Provisional pin map, see above."

  SPLIT_L_WING:
    type: D-sub DB-25 plug
    subtype: male
    pincount: 25
    pinlabels: [SRV1_VPOS, SRV1_GND, SRV1_CANH, SRV1_CANL, SRV2_VPOS, SRV2_GND, SRV2_CANH, SRV2_CANL, ESC1_T, ESC1_S, ESC1_SGND, ESC2_T, ESC2_S, ESC2_SGND, LED1_5V, LED1_SIG, LED1_GND, LED2_5V, LED2_SIG, LED2_GND, LEDT_5V, LEDT_SIG, LEDT_GND, SPARE24, SPARE25]
    hide_disconnected_pins: true
    notes: "Left wing split, wing side. Provisional pin map, see above."

  SPLIT_R_FUS:
    type: D-sub DB-25 socket
    subtype: female
    pincount: 25
    pinlabels: [SRV1_VPOS, SRV1_GND, SRV1_CANH, SRV1_CANL, SRV2_VPOS, SRV2_GND, SRV2_CANH, SRV2_CANL, ESC1_T, ESC1_S, ESC1_SGND, ESC2_T, ESC2_S, ESC2_SGND, LED1_5V, LED1_SIG, LED1_GND, LED2_5V, LED2_SIG, LED2_GND, LEDT_5V, LEDT_SIG, LEDT_GND, SPARE24, SPARE25]
    hide_disconnected_pins: true
    notes: "Right wing split, fuselage side. Provisional pin map, see above."

  SPLIT_R_WING:
    type: D-sub DB-25 plug
    subtype: male
    pincount: 25
    pinlabels: [SRV1_VPOS, SRV1_GND, SRV1_CANH, SRV1_CANL, SRV2_VPOS, SRV2_GND, SRV2_CANH, SRV2_CANL, ESC1_T, ESC1_S, ESC1_SGND, ESC2_T, ESC2_S, ESC2_SGND, LED1_5V, LED1_SIG, LED1_GND, LED2_5V, LED2_SIG, LED2_GND, LEDT_5V, LEDT_SIG, LEDT_GND, SPARE24, SPARE25]
    hide_disconnected_pins: true
    notes: "Right wing split, wing side. Provisional pin map, see above."

  # Zeus Z1500-12V servo, DroneCAN version, one connector per servo. The servo has a 200 mm lead
  # (0.14 mm2 / AWG 26, UL1061) ending in an M5 waterproof 4-pin female connector (datasheet page
  # 10, "M5 Wire"). DroneCAN pin definition: 1 power +, 2 power GND, 3 CAN High, 4 CAN Low.
  # Seen from the mating face the contacts are 3 top left, 4 top right, 2 bottom left, 1 bottom
  # right, with the key at the bottom. Rated 12 V (7 to 15 V); rated current 0.7 A, stall 1.3 A,
  # peak 2.2 A each. The lead belongs to the servo, so nothing goes in the BOM. The mating M5 male
  # plug on the wing cable is SRV_xx_M below.
  SRV_L1:
    type: M5 waterproof 4-pin female (servo lead)
    subtype: female
    manufacturer: Zeus
    notes: "Z1500-12V DroneCAN servo, left wing servo 1. 12 V, 0.7 A rated, 2.2 A peak."
    pinlabels: [V_POS, GND, CAN_H, CAN_L]
    ignore_in_bom: true

  SRV_L2:
    type: M5 waterproof 4-pin female (servo lead)
    subtype: female
    manufacturer: Zeus
    notes: "Z1500-12V DroneCAN servo, left wing servo 2. 12 V, 0.7 A rated, 2.2 A peak."
    pinlabels: [V_POS, GND, CAN_H, CAN_L]
    ignore_in_bom: true

  SRV_R1:
    type: M5 waterproof 4-pin female (servo lead)
    subtype: female
    manufacturer: Zeus
    notes: "Z1500-12V DroneCAN servo, right wing servo 1. 12 V, 0.7 A rated, 2.2 A peak."
    pinlabels: [V_POS, GND, CAN_H, CAN_L]
    ignore_in_bom: true

  SRV_R2:
    type: M5 waterproof 4-pin female (servo lead)
    subtype: female
    manufacturer: Zeus
    notes: "Z1500-12V DroneCAN servo, right wing servo 2. 12 V, 0.7 A rated, 2.2 A peak."
    pinlabels: [V_POS, GND, CAN_H, CAN_L]
    ignore_in_bom: true

  # M5 waterproof 4-pin male plug on the wing cable, one per servo. It mates with the servo's own
  # M5 female lead (SRV_xx above), pin for pin: 1 power +, 2 power GND, 3 CAN High, 4 CAN Low
  # (same numbering as the servo lead, datasheet page 10). The plug is bought, so it is in the BOM.
  # All four wires into the plug are 26 AWG (W_ACT_10 to W_ACT_13 and W_ACT_19 to W_ACT_22), chosen
  # to fit a small M5 solder cup (usually about 24 AWG or thinner).
  # TODO: part number, contact type (solder cup is usual) and the wire range it accepts. Also check
  # the plug's pin current rating against the 2.2 A servo peak.
  SRV_L1_M:
    type: M5 waterproof 4-pin male plug (cable end)
    subtype: male
    notes: "M5 male plug on the left wing servo 1 cable. Mates with the servo lead SRV_L1."
    pinlabels: [V_POS, GND, CAN_H, CAN_L]

  SRV_L2_M:
    type: M5 waterproof 4-pin male plug (cable end)
    subtype: male
    notes: "M5 male plug on the left wing servo 2 cable. Mates with the servo lead SRV_L2."
    pinlabels: [V_POS, GND, CAN_H, CAN_L]

  SRV_R1_M:
    type: M5 waterproof 4-pin male plug (cable end)
    subtype: male
    notes: "M5 male plug on the right wing servo 1 cable. Mates with the servo lead SRV_R1."
    pinlabels: [V_POS, GND, CAN_H, CAN_L]

  SRV_R2_M:
    type: M5 waterproof 4-pin male plug (cable end)
    subtype: male
    notes: "M5 male plug on the right wing servo 2 cable. Mates with the servo lead SRV_R2."
    pinlabels: [V_POS, GND, CAN_H, CAN_L]

  # Teravolt StrobeIT-Pro (two per wing) and StrobeIT (wingtip, one per wing). Both have a
  # standard 3-pin servo-style interface on three solder pads: 5 V input (1 A max), PWM signal,
  # ground. Use a supply that can give 800 mA peak per LED (full-bright strobe).
  # WARNING: the pad order of the two models is mirrored, so a straight cable from the same
  # harness plug would reverse the supply. Pin IDs below are the pad positions left to right as
  # drawn in the vendor pictures: StrobeIT-Pro is +, S, -; StrobeIT is -, S, +.
  # TODO: lead or header type to solder on (not decided).
  LED_L1:
    type: Solder pads
    manufacturer: Teravolt
    notes: "StrobeIT-Pro, left wing LED 1. Pads left to right: 5V, SIGNAL (PWM), GND."
    pinlabels: [5V, SIGNAL, GND]
    ignore_in_bom: true

  LED_L2:
    type: Solder pads
    manufacturer: Teravolt
    notes: "StrobeIT-Pro, left wing LED 2. Pads left to right: 5V, SIGNAL (PWM), GND."
    pinlabels: [5V, SIGNAL, GND]
    ignore_in_bom: true

  LED_LT:
    type: Solder pads
    manufacturer: Teravolt
    notes: "StrobeIT, left wingtip LED. Pads left to right: GND, SIGNAL (PWM), 5V."
    pinlabels: [GND, SIGNAL, 5V]
    ignore_in_bom: true

  LED_R1:
    type: Solder pads
    manufacturer: Teravolt
    notes: "StrobeIT-Pro, right wing LED 1. Pads left to right: 5V, SIGNAL (PWM), GND."
    pinlabels: [5V, SIGNAL, GND]
    ignore_in_bom: true

  LED_R2:
    type: Solder pads
    manufacturer: Teravolt
    notes: "StrobeIT-Pro, right wing LED 2. Pads left to right: 5V, SIGNAL (PWM), GND."
    pinlabels: [5V, SIGNAL, GND]
    ignore_in_bom: true

  LED_RT:
    type: Solder pads
    manufacturer: Teravolt
    notes: "StrobeIT, right wingtip LED. Pads left to right: GND, SIGNAL (PWM), 5V."
    pinlabels: [GND, SIGNAL, 5V]
    ignore_in_bom: true

  # CAN splitter: SwiftWing 6-port passive splitter, JST-GH 4-pin ports. All ports are bussed in
  # parallel inside the splitter (pin 1 = +5 V, 2 = CAN_H, 3 = CAN_L, 4 = GND on every port); it has
  # no termination and no isolation. Each port is modelled as its own connector (harness side
  # housing). Port 1 goes to the Cube CAN2 port and is modelled in flight_control_system.yaml
  # (CAN_SPL_P1), so it is not defined here; ports 2 to 5 take one servo each (no sharing); port 6
  # is spare. Which physical port is which does not matter, they are all the same net.
  # WARNING: the splitter pin 1 is 5 V and bussed. The servos have 12 V on their pin 1, so the servo
  # branches use only CAN_H, CAN_L and GND: pin 1 stays empty on ports 2 to 5. The GND wire is the
  # same DB-25 pin as the servo power GND, so once the 12 V supply is wired the servo return current
  # has two paths (the power wire and, through the splitter GND, the Cube); keep that in mind.
  # NOTE: the Zeus servos have NO built-in CAN termination (mostly confirmed, not yet measured), so
  # the bus end at the Cube (120 ohm on the Cube port) is the only termination on this branch.
  # TODO: confirm by measuring CAN_H to CAN_L on a servo, power off. If a servo does turn out to
  # have a built-in 120 ohm, four of them in parallel (30 ohm) on the bussed splitter would be far
  # below the 60 ohm of a correctly terminated bus. (docs/CAN Termination for Servos.md still
  # says the servos are terminated; that doc is being rewritten.) With no sharing the bus is a star, so the stubs (wing half-span plus fuselage
  # run) are far over the 0.3 m rule of thumb; lower the bitrate if the servos allow it.
  # TODO: GH housing part number and contact type (GHR-04V-S with SSHL-002T-P0.2 for 26 AWG), and
  # confirm that the splitter ports are SM04B-GHS-TB headers.
  CAN_SPL_P2:
    type: JST GH 4-pin
    subtype: female
    manufacturer: JST
    mpn: GHR-04V-S
    notes: "CAN splitter port 2 (passive, bussed): left wing servo 1"
    pinlabels: [VCC_5V, CAN_H, CAN_L, GND]

  CAN_SPL_P3:
    type: JST GH 4-pin
    subtype: female
    manufacturer: JST
    mpn: GHR-04V-S
    notes: "CAN splitter port 3 (passive, bussed): left wing servo 2"
    pinlabels: [VCC_5V, CAN_H, CAN_L, GND]

  CAN_SPL_P4:
    type: JST GH 4-pin
    subtype: female
    manufacturer: JST
    mpn: GHR-04V-S
    notes: "CAN splitter port 4 (passive, bussed): right wing servo 1"
    pinlabels: [VCC_5V, CAN_H, CAN_L, GND]

  CAN_SPL_P5:
    type: JST GH 4-pin
    subtype: female
    manufacturer: JST
    mpn: GHR-04V-S
    notes: "CAN splitter port 5 (passive, bussed): right wing servo 2"
    pinlabels: [VCC_5V, CAN_H, CAN_L, GND]


cables:

  # XT90 male at the wing split -> ESC battery input, one cable per VTOL motor.
  # 10 AWG (recommendation). Motor current is about 16 A at 6 kg thrust and about 75-80 A at full
  # throttle (Vector Technics 8020 PRO 120KV test table, 12S, 30-32 inch props); battery-side
  # current is about the same. 10 AWG silicone wire handles that over a short run and fits the XT90
  # solder cup. APD says to keep the ESC input wires short (long wires cause voltage spikes
  # when the motor brakes); see the capacitor note on the ESC connectors.
  # TODO: confirm with real lengths; go to 8 AWG if the run is long or hot.
  W_ACT_01:
    wirecount: 2
    gauge: 10 AWG
    colors: [RD, BK]
    length: 0   # TODO: real length after layout analysis (wing split to ESC)
    notes: "VTOL motor 1 (front right) power, wing split to ESC"

  W_ACT_02:
    wirecount: 2
    gauge: 10 AWG
    colors: [RD, BK]
    length: 0   # TODO: real length after layout analysis (wing split to ESC)
    notes: "VTOL motor 2 (rear left) power, wing split to ESC"

  W_ACT_03:
    wirecount: 2
    gauge: 10 AWG
    colors: [RD, BK]
    length: 0   # TODO: real length after layout analysis (wing split to ESC)
    notes: "VTOL motor 3 (front left) power, wing split to ESC"

  W_ACT_04:
    wirecount: 2
    gauge: 10 AWG
    colors: [RD, BK]
    length: 0   # TODO: real length after layout analysis (wing split to ESC)
    notes: "VTOL motor 4 (rear right) power, wing split to ESC"

  # ESC motor phase pads -> motor. These are the motor's own leads, so they stay out of the BOM.
  # Gauge and colors are not in the listing; leave the gauge open until the motor is checked.
  # The phase current is roughly the same as the battery current, so if the leads are ever
  # extended, use the same gauge as the cables above (10 AWG). Colors below only tell the ends
  # apart. Phase order does not matter electrically (it sets the spin direction).
  # TODO: real colors, gauge and length from the motor.
  W_ACT_05:
    wirecount: 3
    colors: [YE, GN, BU]
    length: 0   # TODO: real length (motor leads, as short as possible)
    ignore_in_bom: true
    notes: "VTOL motor 1 (front right) phase leads"

  W_ACT_06:
    wirecount: 3
    colors: [YE, GN, BU]
    length: 0   # TODO: real length (motor leads, as short as possible)
    ignore_in_bom: true
    notes: "VTOL motor 2 (rear left) phase leads"

  W_ACT_07:
    wirecount: 3
    colors: [YE, GN, BU]
    length: 0   # TODO: real length (motor leads, as short as possible)
    ignore_in_bom: true
    notes: "VTOL motor 3 (front left) phase leads"

  W_ACT_08:
    wirecount: 3
    colors: [YE, GN, BU]
    length: 0   # TODO: real length (motor leads, as short as possible)
    ignore_in_bom: true
    notes: "VTOL motor 4 (rear right) phase leads"

  # Forward ESC motor phase pads -> forward motor. The motor's own leads, so out of the BOM.
  # Gauge, colors and length are not known. If the leads are ever extended, use 10 AWG (the phase
  # current is about the same as the battery current). Colors only tell the ends apart.
  # TODO: real colors, gauge and length from the motor.
  W_ACT_09:
    wirecount: 3
    colors: [YE, GN, BU]
    length: 0   # TODO: real length (motor leads, as short as possible)
    ignore_in_bom: true
    notes: "Forward motor phase leads"

  # ---- Wing split, no sharing ----------------------------------------------------------
  # Wing side: DB-25 plug -> servo M5 plug, LED and ESC signal pads (one cable per link).
  # LED wires: 22 AWG (LED 0.8 A peak; the run may be a few metres).
  # Servo power, signal and CAN wires: 26 AWG. The servo power wires are 26 AWG so they fit the M5
  # plug solder cups (the servo lead itself is 26 AWG, and GH contacts take 26 AWG at most). The
  # cost is voltage drop, see the comment above each servo power cable.
  # Colors: servo CAN_H yellow, CAN_L green; ESC T yellow, S white, signal GND black; LED 5 V red,
  # signal white, GND black.
  # TODO: twisted pair for CAN and for each ESC T/S/GND trio (APD: signal GND twisted with the signal).
  # Servo power, 26 AWG: voltage drop. 26 AWG is about 0.13 ohm per metre, so over 3 m one way (6 m
  # loop) the 2.2 A servo peak drops about 1.8 V and the 0.7 A rated current about 0.6 V. The servo
  # takes 7 to 15 V and is fed 12 V, so check that the supply and the real wire length leave enough
  # margin; shorten the run or raise the supply voltage if not.
  W_ACT_10:
    wirecount: 2
    gauge: 26 AWG
    colors: [RD, BK]
    length: 0   # TODO: real length after layout analysis (wing plug to servo)
    notes: "Left wing servo 1 power: 12 V and GND, wing plug to servo"
  W_ACT_11:
    wirecount: 2
    gauge: 26 AWG
    colors: [YE, GN]
    length: 0   # TODO: real length after layout analysis (wing plug to servo)
    notes: "Left wing servo 1 CAN pair, wing plug to servo (twisted pair)"
  # Servo power, 26 AWG: voltage drop is about 1.8 V at the 2.2 A peak over a 3 m run one way (see W_ACT_10).
  W_ACT_12:
    wirecount: 2
    gauge: 26 AWG
    colors: [RD, BK]
    length: 0   # TODO: real length after layout analysis (wing plug to servo)
    notes: "Left wing servo 2 power: 12 V and GND, wing plug to servo"
  W_ACT_13:
    wirecount: 2
    gauge: 26 AWG
    colors: [YE, GN]
    length: 0   # TODO: real length after layout analysis (wing plug to servo)
    notes: "Left wing servo 2 CAN pair, wing plug to servo (twisted pair)"
  W_ACT_14:
    wirecount: 3
    gauge: 22 AWG
    colors: [RD, WH, BK]
    length: 0   # TODO: real length after layout analysis (wing plug to LED)
    notes: "Left wing LED 1 (StrobeIT-Pro): 5 V, signal, GND, wing plug to LED"
  W_ACT_15:
    wirecount: 3
    gauge: 22 AWG
    colors: [RD, WH, BK]
    length: 0   # TODO: real length after layout analysis (wing plug to LED)
    notes: "Left wing LED 2 (StrobeIT-Pro): 5 V, signal, GND, wing plug to LED"
  W_ACT_16:
    wirecount: 3
    gauge: 22 AWG
    colors: [RD, WH, BK]
    length: 0   # TODO: real length after layout analysis (wing plug to LED)
    notes: "Left wing wingtip LED (StrobeIT): 5 V, signal, GND, wing plug to LED"
  W_ACT_17:
    wirecount: 3
    gauge: 26 AWG
    colors: [YE, WH, BK]
    length: 0   # TODO: real length after layout analysis (wing plug to ESC)
    notes: "Left wing ESC 1 (forward boom, VTOL motor 3, front left) signal: T, S, signal GND, wing plug to ESC"
  W_ACT_18:
    wirecount: 3
    gauge: 26 AWG
    colors: [YE, WH, BK]
    length: 0   # TODO: real length after layout analysis (wing plug to ESC)
    notes: "Left wing ESC 2 (aft boom, VTOL motor 2, rear left) signal: T, S, signal GND, wing plug to ESC"
  # Servo power, 26 AWG: voltage drop is about 1.8 V at the 2.2 A peak over a 3 m run one way (see W_ACT_10).
  W_ACT_19:
    wirecount: 2
    gauge: 26 AWG
    colors: [RD, BK]
    length: 0   # TODO: real length after layout analysis (wing plug to servo)
    notes: "Right wing servo 1 power: 12 V and GND, wing plug to servo"
  W_ACT_20:
    wirecount: 2
    gauge: 26 AWG
    colors: [YE, GN]
    length: 0   # TODO: real length after layout analysis (wing plug to servo)
    notes: "Right wing servo 1 CAN pair, wing plug to servo (twisted pair)"
  # Servo power, 26 AWG: voltage drop is about 1.8 V at the 2.2 A peak over a 3 m run one way (see W_ACT_10).
  W_ACT_21:
    wirecount: 2
    gauge: 26 AWG
    colors: [RD, BK]
    length: 0   # TODO: real length after layout analysis (wing plug to servo)
    notes: "Right wing servo 2 power: 12 V and GND, wing plug to servo"
  W_ACT_22:
    wirecount: 2
    gauge: 26 AWG
    colors: [YE, GN]
    length: 0   # TODO: real length after layout analysis (wing plug to servo)
    notes: "Right wing servo 2 CAN pair, wing plug to servo (twisted pair)"
  W_ACT_23:
    wirecount: 3
    gauge: 22 AWG
    colors: [RD, WH, BK]
    length: 0   # TODO: real length after layout analysis (wing plug to LED)
    notes: "Right wing LED 1 (StrobeIT-Pro): 5 V, signal, GND, wing plug to LED"
  W_ACT_24:
    wirecount: 3
    gauge: 22 AWG
    colors: [RD, WH, BK]
    length: 0   # TODO: real length after layout analysis (wing plug to LED)
    notes: "Right wing LED 2 (StrobeIT-Pro): 5 V, signal, GND, wing plug to LED"
  W_ACT_25:
    wirecount: 3
    gauge: 22 AWG
    colors: [RD, WH, BK]
    length: 0   # TODO: real length after layout analysis (wing plug to LED)
    notes: "Right wing wingtip LED (StrobeIT): 5 V, signal, GND, wing plug to LED"
  W_ACT_26:
    wirecount: 3
    gauge: 26 AWG
    colors: [YE, WH, BK]
    length: 0   # TODO: real length after layout analysis (wing plug to ESC)
    notes: "Right wing ESC 1 (forward boom, VTOL motor 1, front right) signal: T, S, signal GND, wing plug to ESC"
  W_ACT_27:
    wirecount: 3
    gauge: 26 AWG
    colors: [YE, WH, BK]
    length: 0   # TODO: real length after layout analysis (wing plug to ESC)
    notes: "Right wing ESC 2 (aft boom, VTOL motor 4, rear right) signal: T, S, signal GND, wing plug to ESC"

  # Fuselage side: DB-25 socket CAN_H, CAN_L and GND of each servo -> its own port on the CAN
  # splitter (GH housing pins 2, 3, 4). No 5 V (pin 1 stays empty), see the splitter warnings in
  # the connectors section. The servo power (12 V) is not wired on the fuselage side yet.
  # Colors: CAN_H yellow, CAN_L green, GND black. Twist CAN_H with CAN_L.
  W_ACT_28:
    wirecount: 3
    gauge: 26 AWG
    colors: [YE, GN, BK]
    length: 0   # TODO: real length after layout analysis (fuselage DB-25 to splitter)
    notes: "Left wing servo 1 CAN_H, CAN_L and GND, fuselage DB-25 to CAN splitter (twist CAN_H/CAN_L)"
  W_ACT_29:
    wirecount: 3
    gauge: 26 AWG
    colors: [YE, GN, BK]
    length: 0   # TODO: real length after layout analysis (fuselage DB-25 to splitter)
    notes: "Left wing servo 2 CAN_H, CAN_L and GND, fuselage DB-25 to CAN splitter (twist CAN_H/CAN_L)"
  W_ACT_30:
    wirecount: 3
    gauge: 26 AWG
    colors: [YE, GN, BK]
    length: 0   # TODO: real length after layout analysis (fuselage DB-25 to splitter)
    notes: "Right wing servo 1 CAN_H, CAN_L and GND, fuselage DB-25 to CAN splitter (twist CAN_H/CAN_L)"
  W_ACT_31:
    wirecount: 3
    gauge: 26 AWG
    colors: [YE, GN, BK]
    length: 0   # TODO: real length after layout analysis (fuselage DB-25 to splitter)
    notes: "Right wing servo 2 CAN_H, CAN_L and GND, fuselage DB-25 to CAN splitter (twist CAN_H/CAN_L)"

  # ---- ESC input capacitors: direct capacitor legs soldered to the ESC pads ----------------
  # These are not real cables: the capacitor's own legs go straight onto the exposed copper of the
  # ESC capacitor pads, so nothing goes in the BOM. Colors only tell the legs apart (red = positive,
  # the longer leg; black = negative, the grey stripe side). Keep the legs as short as possible and
  # fold them close to the body (APD).
  # TODO: real leg length (a few mm).
  W_ACT_32:
    wirecount: 2
    colors: [RD, BK]
    length: 0
    ignore_in_bom: true
    notes: "Direct capacitor legs soldered: VTOL motor 1 (front right) ESC, capacitor 1 of 2"
  W_ACT_33:
    wirecount: 2
    colors: [RD, BK]
    length: 0
    ignore_in_bom: true
    notes: "Direct capacitor legs soldered: VTOL motor 1 (front right) ESC, capacitor 2 of 2"
  W_ACT_34:
    wirecount: 2
    colors: [RD, BK]
    length: 0
    ignore_in_bom: true
    notes: "Direct capacitor legs soldered: VTOL motor 2 (rear left) ESC, capacitor 1 of 2"
  W_ACT_35:
    wirecount: 2
    colors: [RD, BK]
    length: 0
    ignore_in_bom: true
    notes: "Direct capacitor legs soldered: VTOL motor 2 (rear left) ESC, capacitor 2 of 2"
  W_ACT_36:
    wirecount: 2
    colors: [RD, BK]
    length: 0
    ignore_in_bom: true
    notes: "Direct capacitor legs soldered: VTOL motor 3 (front left) ESC, capacitor 1 of 2"
  W_ACT_37:
    wirecount: 2
    colors: [RD, BK]
    length: 0
    ignore_in_bom: true
    notes: "Direct capacitor legs soldered: VTOL motor 3 (front left) ESC, capacitor 2 of 2"
  W_ACT_38:
    wirecount: 2
    colors: [RD, BK]
    length: 0
    ignore_in_bom: true
    notes: "Direct capacitor legs soldered: VTOL motor 4 (rear right) ESC, capacitor 1 of 2"
  W_ACT_39:
    wirecount: 2
    colors: [RD, BK]
    length: 0
    ignore_in_bom: true
    notes: "Direct capacitor legs soldered: VTOL motor 4 (rear right) ESC, capacitor 2 of 2"
  W_ACT_40:
    wirecount: 2
    colors: [RD, BK]
    length: 0
    ignore_in_bom: true
    notes: "Direct capacitor legs soldered: forward ESC, capacitor 1 of 2"
  W_ACT_41:
    wirecount: 2
    colors: [RD, BK]
    length: 0
    ignore_in_bom: true
    notes: "Direct capacitor legs soldered: forward ESC, capacitor 2 of 2"

connections:

  # XT90 male at the wing split -> ESC input, VTOL motors 1 to 4.
  # Motor numbers follow the ArduPilot QuadPlane Quad X default: 1 front right (CCW), 2 rear left (CCW),
  # 3 front left (CW), 4 rear right (CW); left wing = motors 3 and 2, right wing = motors 1 and 4.
  # TODO: check the spin direction on the real build (swap two phase wires to reverse a motor).
  - - XT90_VTOL1_M: [POS, NEG]
    - W_ACT_01: [1, 2]
    - ESC_VTOL1_IN: [IN_POS, IN_NEG]
  - - XT90_VTOL2_M: [POS, NEG]
    - W_ACT_02: [1, 2]
    - ESC_VTOL2_IN: [IN_POS, IN_NEG]
  - - XT90_VTOL3_M: [POS, NEG]
    - W_ACT_03: [1, 2]
    - ESC_VTOL3_IN: [IN_POS, IN_NEG]
  - - XT90_VTOL4_M: [POS, NEG]
    - W_ACT_04: [1, 2]
    - ESC_VTOL4_IN: [IN_POS, IN_NEG]

  # ESC motor phase pads -> motor, VTOL motors 1 to 4.
  - - ESC_VTOL1_PH: [PH_A, PH_B, PH_C]
    - W_ACT_05: [1, 2, 3]
    - MOT_VTOL1: [PH_A, PH_B, PH_C]
  - - ESC_VTOL2_PH: [PH_A, PH_B, PH_C]
    - W_ACT_06: [1, 2, 3]
    - MOT_VTOL2: [PH_A, PH_B, PH_C]
  - - ESC_VTOL3_PH: [PH_A, PH_B, PH_C]
    - W_ACT_07: [1, 2, 3]
    - MOT_VTOL3: [PH_A, PH_B, PH_C]
  - - ESC_VTOL4_PH: [PH_A, PH_B, PH_C]
    - W_ACT_08: [1, 2, 3]
    - MOT_VTOL4: [PH_A, PH_B, PH_C]

  # Forward ESC motor phase pads -> forward motor.
  - - ESC_FWD_PH: [PH_A, PH_B, PH_C]
    - W_ACT_09: [1, 2, 3]
    - MOT_FWD: [PH_A, PH_B, PH_C]

  # ==== Wing split, no sharing (provisional DB-25 pin map) ================================
  # DB-25 mates: fuselage socket to wing plug, pin for pin (pins 1 to 23; the mate needs pin
  # numbers, the cables use the pin labels).

  # Left wing
  -
    - SPLIT_L_FUS: [1, 2, 3, 4, 5, 6, 7, 8, 9, 10, 11, 12, 13, 14, 15, 16, 17, 18, 19, 20, 21, 22, 23]
    - -->
    - SPLIT_L_WING: [1, 2, 3, 4, 5, 6, 7, 8, 9, 10, 11, 12, 13, 14, 15, 16, 17, 18, 19, 20, 21, 22, 23]
  -
    - SPLIT_L_WING: [SRV1_VPOS, SRV1_GND]
    - W_ACT_10: [1, 2]
    - SRV_L1_M: [V_POS, GND]
  -
    - SPLIT_L_WING: [SRV1_CANH, SRV1_CANL]
    - W_ACT_11: [1, 2]
    - SRV_L1_M: [CAN_H, CAN_L]
  -
    - SRV_L1_M: [1, 2, 3, 4]
    - -->
    - SRV_L1: [1, 2, 3, 4]
  -
    - SPLIT_L_WING: [SRV2_VPOS, SRV2_GND]
    - W_ACT_12: [1, 2]
    - SRV_L2_M: [V_POS, GND]
  -
    - SPLIT_L_WING: [SRV2_CANH, SRV2_CANL]
    - W_ACT_13: [1, 2]
    - SRV_L2_M: [CAN_H, CAN_L]
  -
    - SRV_L2_M: [1, 2, 3, 4]
    - -->
    - SRV_L2: [1, 2, 3, 4]
  -
    - SPLIT_L_WING: [LED1_5V, LED1_SIG, LED1_GND]
    - W_ACT_14: [1, 2, 3]
    - LED_L1: [5V, SIGNAL, GND]
  -
    - SPLIT_L_WING: [LED2_5V, LED2_SIG, LED2_GND]
    - W_ACT_15: [1, 2, 3]
    - LED_L2: [5V, SIGNAL, GND]
  -
    - SPLIT_L_WING: [LEDT_5V, LEDT_SIG, LEDT_GND]
    - W_ACT_16: [1, 2, 3]
    - LED_LT: [5V, SIGNAL, GND]
  -
    - SPLIT_L_WING: [ESC1_T, ESC1_S, ESC1_SGND]
    - W_ACT_17: [1, 2, 3]
    - ESC_VTOL3_SIG: [T, S, SIG_GND]
  -
    - SPLIT_L_WING: [ESC2_T, ESC2_S, ESC2_SGND]
    - W_ACT_18: [1, 2, 3]
    - ESC_VTOL2_SIG: [T, S, SIG_GND]
  -
    - SPLIT_L_FUS: [SRV1_CANH, SRV1_CANL, SRV1_GND]
    - W_ACT_28: [1, 2, 3]
    - CAN_SPL_P2: [CAN_H, CAN_L, GND]
  -
    - SPLIT_L_FUS: [SRV2_CANH, SRV2_CANL, SRV2_GND]
    - W_ACT_29: [1, 2, 3]
    - CAN_SPL_P3: [CAN_H, CAN_L, GND]

  # Right wing
  -
    - SPLIT_R_FUS: [1, 2, 3, 4, 5, 6, 7, 8, 9, 10, 11, 12, 13, 14, 15, 16, 17, 18, 19, 20, 21, 22, 23]
    - -->
    - SPLIT_R_WING: [1, 2, 3, 4, 5, 6, 7, 8, 9, 10, 11, 12, 13, 14, 15, 16, 17, 18, 19, 20, 21, 22, 23]
  -
    - SPLIT_R_WING: [SRV1_VPOS, SRV1_GND]
    - W_ACT_19: [1, 2]
    - SRV_R1_M: [V_POS, GND]
  -
    - SPLIT_R_WING: [SRV1_CANH, SRV1_CANL]
    - W_ACT_20: [1, 2]
    - SRV_R1_M: [CAN_H, CAN_L]
  -
    - SRV_R1_M: [1, 2, 3, 4]
    - -->
    - SRV_R1: [1, 2, 3, 4]
  -
    - SPLIT_R_WING: [SRV2_VPOS, SRV2_GND]
    - W_ACT_21: [1, 2]
    - SRV_R2_M: [V_POS, GND]
  -
    - SPLIT_R_WING: [SRV2_CANH, SRV2_CANL]
    - W_ACT_22: [1, 2]
    - SRV_R2_M: [CAN_H, CAN_L]
  -
    - SRV_R2_M: [1, 2, 3, 4]
    - -->
    - SRV_R2: [1, 2, 3, 4]
  -
    - SPLIT_R_WING: [LED1_5V, LED1_SIG, LED1_GND]
    - W_ACT_23: [1, 2, 3]
    - LED_R1: [5V, SIGNAL, GND]
  -
    - SPLIT_R_WING: [LED2_5V, LED2_SIG, LED2_GND]
    - W_ACT_24: [1, 2, 3]
    - LED_R2: [5V, SIGNAL, GND]
  -
    - SPLIT_R_WING: [LEDT_5V, LEDT_SIG, LEDT_GND]
    - W_ACT_25: [1, 2, 3]
    - LED_RT: [5V, SIGNAL, GND]
  -
    - SPLIT_R_WING: [ESC1_T, ESC1_S, ESC1_SGND]
    - W_ACT_26: [1, 2, 3]
    - ESC_VTOL1_SIG: [T, S, SIG_GND]
  -
    - SPLIT_R_WING: [ESC2_T, ESC2_S, ESC2_SGND]
    - W_ACT_27: [1, 2, 3]
    - ESC_VTOL4_SIG: [T, S, SIG_GND]
  -
    - SPLIT_R_FUS: [SRV1_CANH, SRV1_CANL, SRV1_GND]
    - W_ACT_30: [1, 2, 3]
    - CAN_SPL_P4: [CAN_H, CAN_L, GND]
  -
    - SPLIT_R_FUS: [SRV2_CANH, SRV2_CANL, SRV2_GND]
    - W_ACT_31: [1, 2, 3]
    - CAN_SPL_P5: [CAN_H, CAN_L, GND]

  # ==== ESC input capacitors (2 per ESC, from the ESC box) ==================================
  # Both capacitors of an ESC sit on the same pad pair (in parallel). The capacitor legs are
  # soldered directly to the ESC pads, see the W_ACT_32 to W_ACT_41 comment.
  - - CAP_VTOL1_A: [CAP_POS, CAP_NEG]
    - W_ACT_32: [1, 2]
    - ESC_VTOL1_CAP: [CAP_POS, CAP_NEG]
  - - CAP_VTOL1_B: [CAP_POS, CAP_NEG]
    - W_ACT_33: [1, 2]
    - ESC_VTOL1_CAP: [CAP_POS, CAP_NEG]
  - - CAP_VTOL2_A: [CAP_POS, CAP_NEG]
    - W_ACT_34: [1, 2]
    - ESC_VTOL2_CAP: [CAP_POS, CAP_NEG]
  - - CAP_VTOL2_B: [CAP_POS, CAP_NEG]
    - W_ACT_35: [1, 2]
    - ESC_VTOL2_CAP: [CAP_POS, CAP_NEG]
  - - CAP_VTOL3_A: [CAP_POS, CAP_NEG]
    - W_ACT_36: [1, 2]
    - ESC_VTOL3_CAP: [CAP_POS, CAP_NEG]
  - - CAP_VTOL3_B: [CAP_POS, CAP_NEG]
    - W_ACT_37: [1, 2]
    - ESC_VTOL3_CAP: [CAP_POS, CAP_NEG]
  - - CAP_VTOL4_A: [CAP_POS, CAP_NEG]
    - W_ACT_38: [1, 2]
    - ESC_VTOL4_CAP: [CAP_POS, CAP_NEG]
  - - CAP_VTOL4_B: [CAP_POS, CAP_NEG]
    - W_ACT_39: [1, 2]
    - ESC_VTOL4_CAP: [CAP_POS, CAP_NEG]
  - - CAP_FWD_A: [CAP_POS, CAP_NEG]
    - W_ACT_40: [1, 2]
    - ESC_FWD_CAP: [CAP_POS, CAP_NEG]
  - - CAP_FWD_B: [CAP_POS, CAP_NEG]
    - W_ACT_41: [1, 2]
    - ESC_FWD_CAP: [CAP_POS, CAP_NEG]
