harshabose/sagewire/(commit log)

2026-11-11 power_system.yaml done
2026-11-13 second pass
    [Avionics Selection.xlsx, SAGE_Master.step, initial_selection.xlsx]
2026-11-13 Harness: A8-MINI, servo M5 plugs, CAN daisy chain, ESC capacitors, wire list
    Done:
    - cellular: replace A2-MINI with A8-MINI (9-pin Ethernet port to RJ45 plug
    to Jetson, 4-pin power port to XT30 male mated with XT30 female)
    - actuators: M5 male plugs for the four servos (servo power wires now
    26 AWG), servo CAN_H/CAN_L/GND to splitter ports 2-5, both input
    capacitors from each ESC box wired as direct capacitor legs soldered
    - flight control: airspeed sensor daisy-chained behind the GPS (CAN1.2),
    Cube CAN2 to CAN splitter port 1
    - docs: add wire_list.md (all 60 cables with gauge, from/to, comments)
    Blocker:
    - BEC architecture is not decided, so the A8-MINI XT30 female, Jetson,
    radio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
    [actuators_system.yaml, cellular_system.yaml, flight_control_system.yaml]
2026-11-13 Harness: resolve termination and ESC voltage notes, Cube CAN connectors, TODO tags
    - Remove the ESC 12S / 50.4 V check TODOs (APD confirmed the limit is fine).
    - Servo termination: note the Zeus servos have no built-in termination
    (mostly confirmed, still to be measured).
    - Sierra: GPS termination off (default); airspeed far-end termination
    left undecided.
    - Cube CAN1/CAN2 plugs modelled as JST GH 4-pin (GHR-04V-S), per the
    CubePilot interface spec; series still to be confirmed on the carrier.
    - A8-MINI: record manual power spec (11-25.2 V, 5 W avg, 12 W peak);
    housing series and pin 1 still open.
    - XT90 fixed to the plain variant for now and DB-25 pin map kept
    provisional, both ta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
    [actuators_system.yaml, cellular_system.yaml, flight_control_system.yaml, power_system.yaml, rf_system.yaml]
2026-11-13 Harness: radio Ethernet to Jetson, Cube TELEM2 to Jetson via TTL-to-USB
    - RF system: wire the Mesh Rider Ethernet port (RF_P2) to an RJ45 plug
    (W_RF_02, crossover, T568B colours) that mates with the Jetson second
    Ethernet port (JET_ETH2).
    - Cellular system: wire Cube TELEM2 (TX, RX, GND) to a TTL-to-USB
    converter (W_CEL_05, 28 AWG placeholder) that plugs straight into the
    Jetson USB 2.0 jack (JET_USB3).
    - Part numbers, converter details, RJ45 plug and which Jetson ports are
    used are tagged TODO.
    - Add the new cables to the wire-list generator (docs/wire_list.md not
    regenerated).
    Blocker: BEC architecture. Pending: review of wire gauges.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
